Arranua/automated-wheel-installation-system/images/sequence/PLC Sequence 5.jpeg

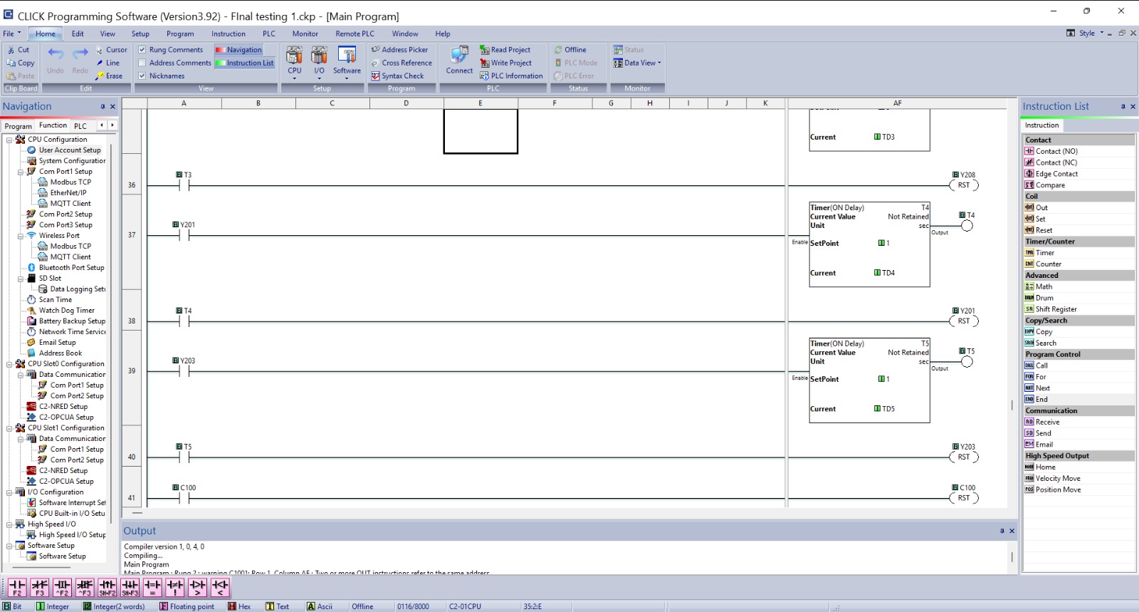
images/sequence/PLC Sequence 5.jpeg
