Arranua/automated-wheel-installation-system/images/sequence/PLC Sequence 1.jpeg

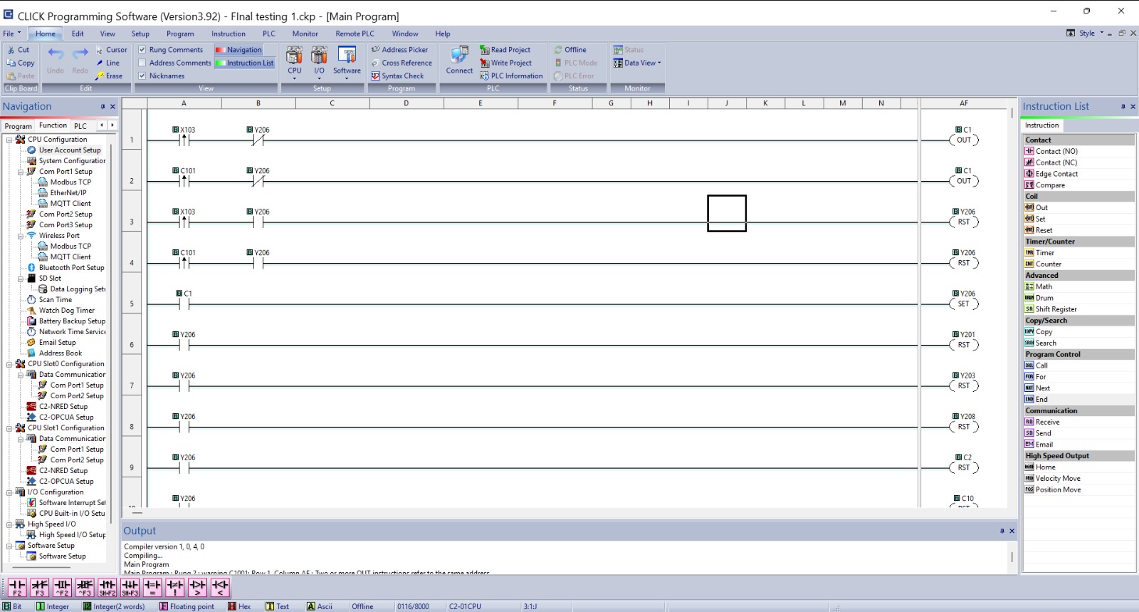
images/sequence/PLC Sequence 1.jpeg
