Arranua/automated-wheel-installation-system/code/plc/README.md

# PLC Code

PLC screenshots, exported program files, ladder logic images, or state-machine notes here.

Expected responsibilities:

- start / stop / reset sequence
- sensor validation
- ESP32 start commands
- done feedback handling
- solenoid/trapdoor output
- cycle complete logic
