Arranua/automated-wheel-installation-system/08_Future_Work.md

# 08 - Future Work

## Planned Improvements

- add final wiring diagrams
- add final NX assembly screenshots
- add full operation video
- add PLC screenshots and ladder/function block screenshots
- improve cable routing and labeling
- add more sensor confirmation points
- improve mechanical wheel alignment features
- create a cleaner HMI or Node-RED dashboard

## Industrial Upgrade Ideas

- closed-loop stepper or servo feedback
- fault codes on HMI/SCADA screen
- dedicated motor controllers instead of prototype wiring
- fused DC distribution
- DIN rail terminals and labeled wiring
- panel-mounted relays and interface modules
- more robust guarding and safety interlocks
