Arranua/automated-wheel-installation-system/images/CAD/gantry plates 2.png

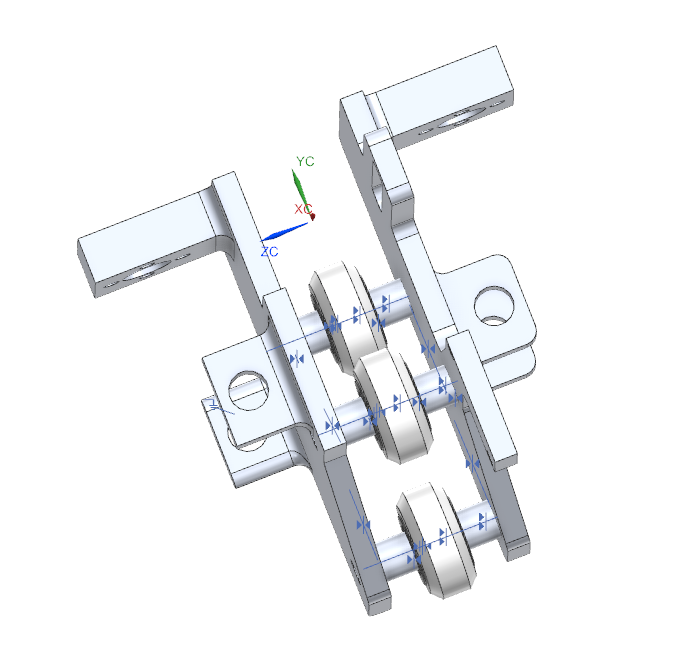
images/CAD/gantry plates 2.png
