Arranua/automated-wheel-installation-system/images/CAD/gantry plates.png

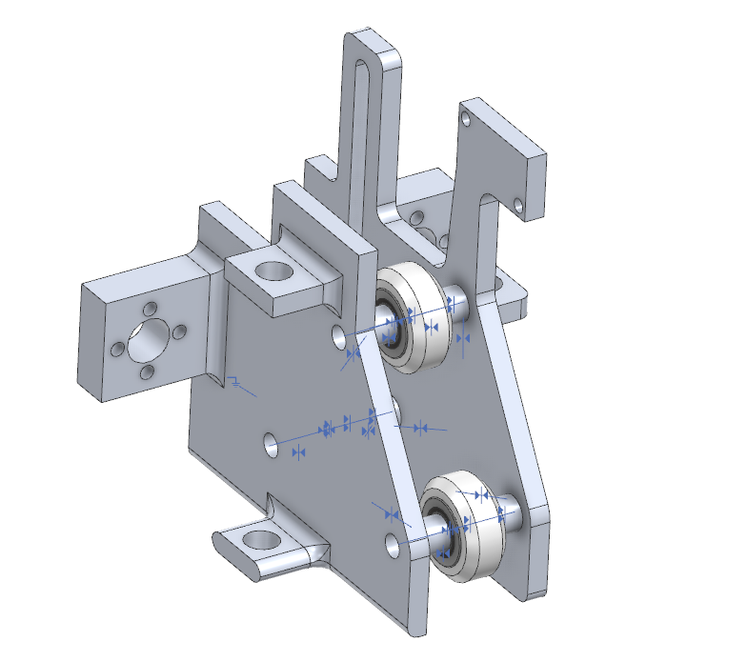
images/CAD/gantry plates.png
