Arranua/automated-wheel-installation-system/images/CAD/gripper.png

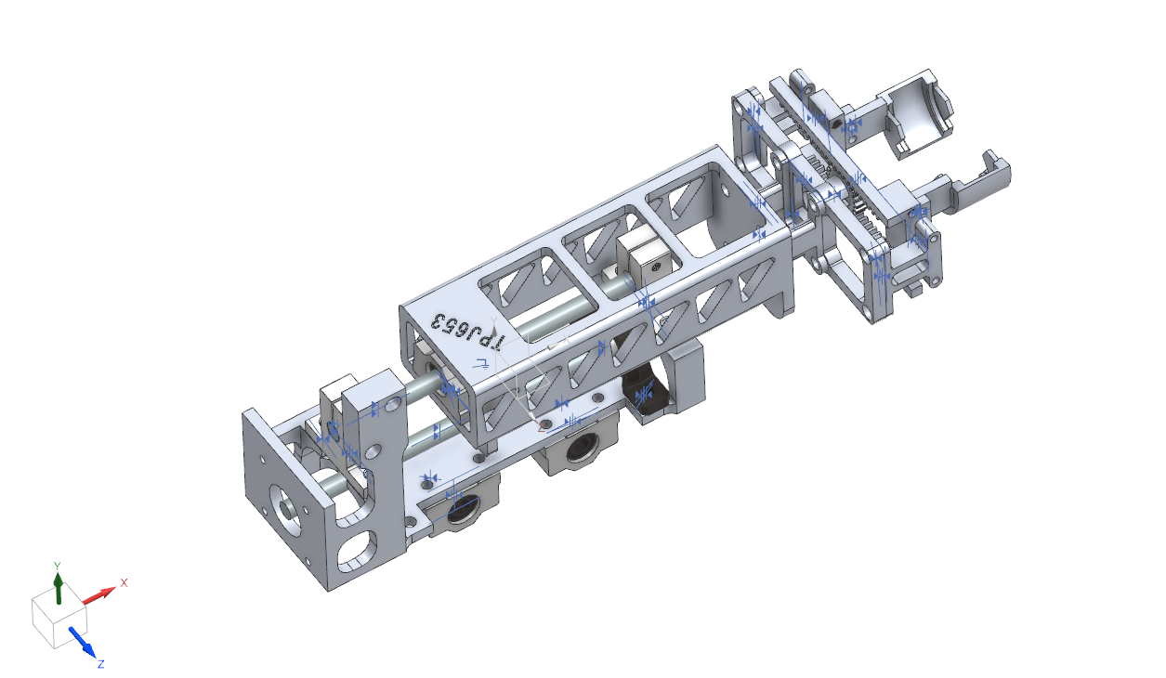
images/CAD/gripper.png
