Arranua/automated-wheel-installation-system/images/CAD/wheel magazine.png

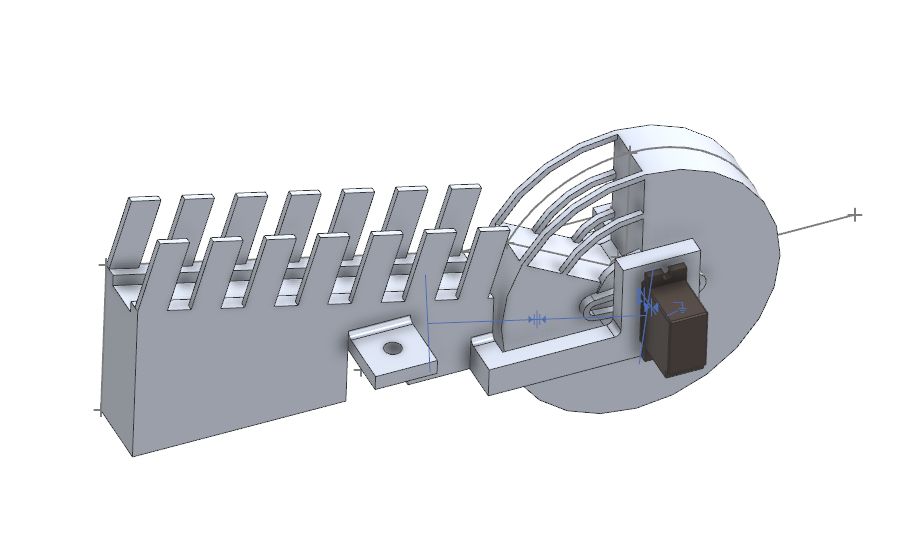
images/CAD/wheel magazine.png
