Arranua/automated-wheel-installation-system/images/scada_iot/dashboard.jpeg

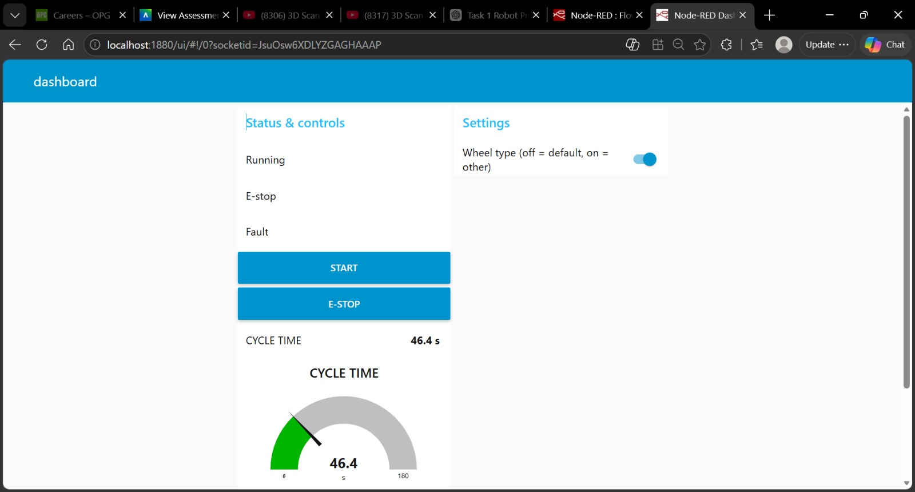
images/scada_iot/dashboard.jpeg
