Arranua/automated-wheel-installation-system/images/sequence/PLC Sequence 2.jpeg

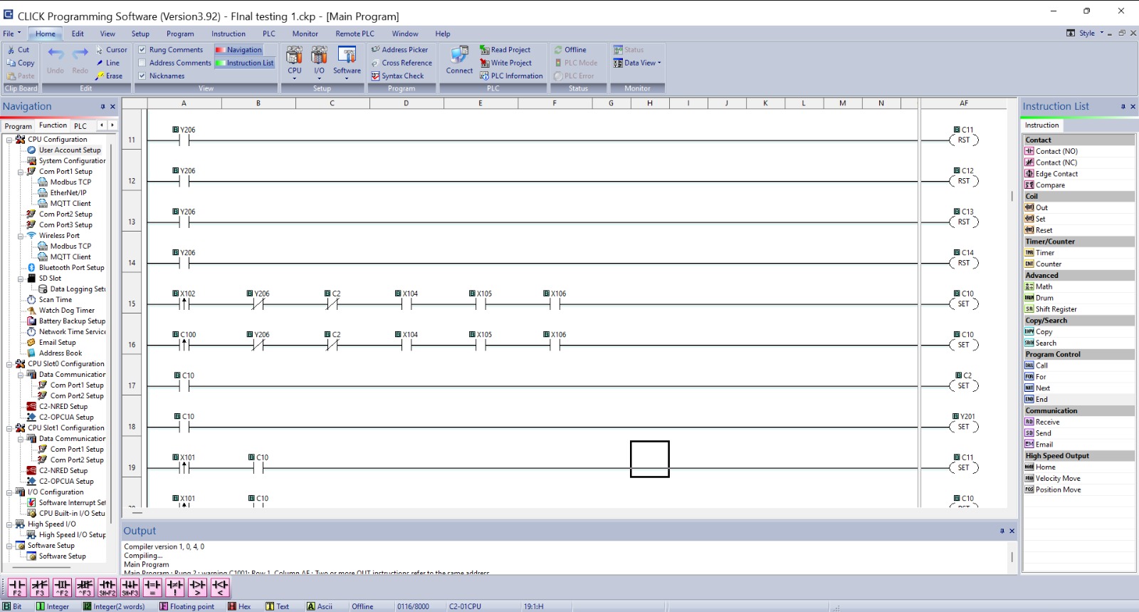
images/sequence/PLC Sequence 2.jpeg
