Arranua/automated-wheel-installation-system/images/sequence/PLC Sequence 3.jpeg

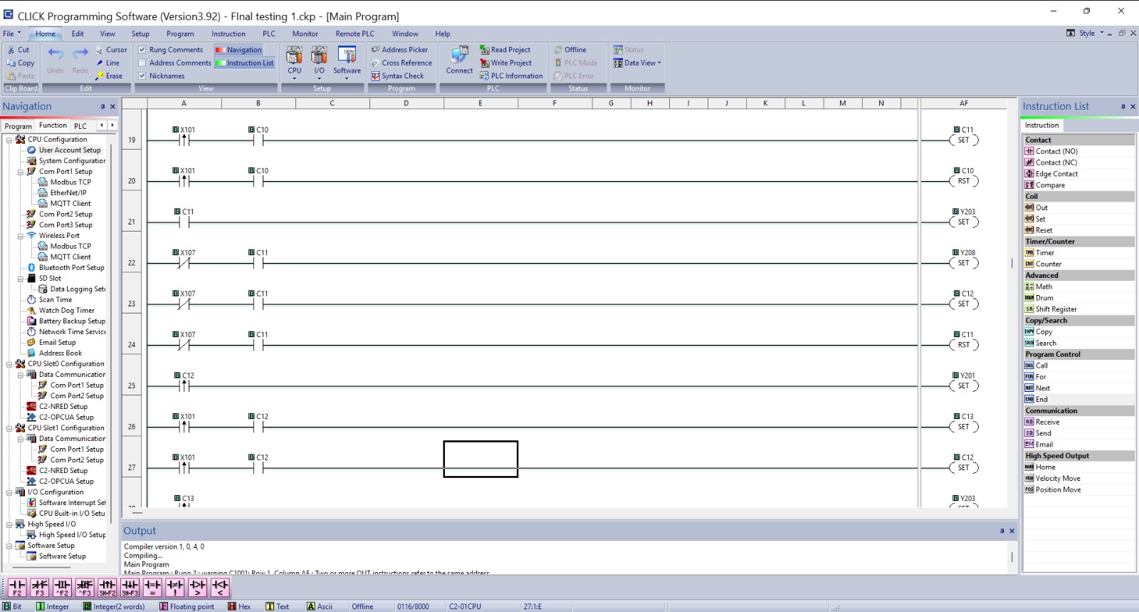
images/sequence/PLC Sequence 3.jpeg
