Arranua/automated-wheel-installation-system/images/sequence/PLC Sequence 6.jpeg

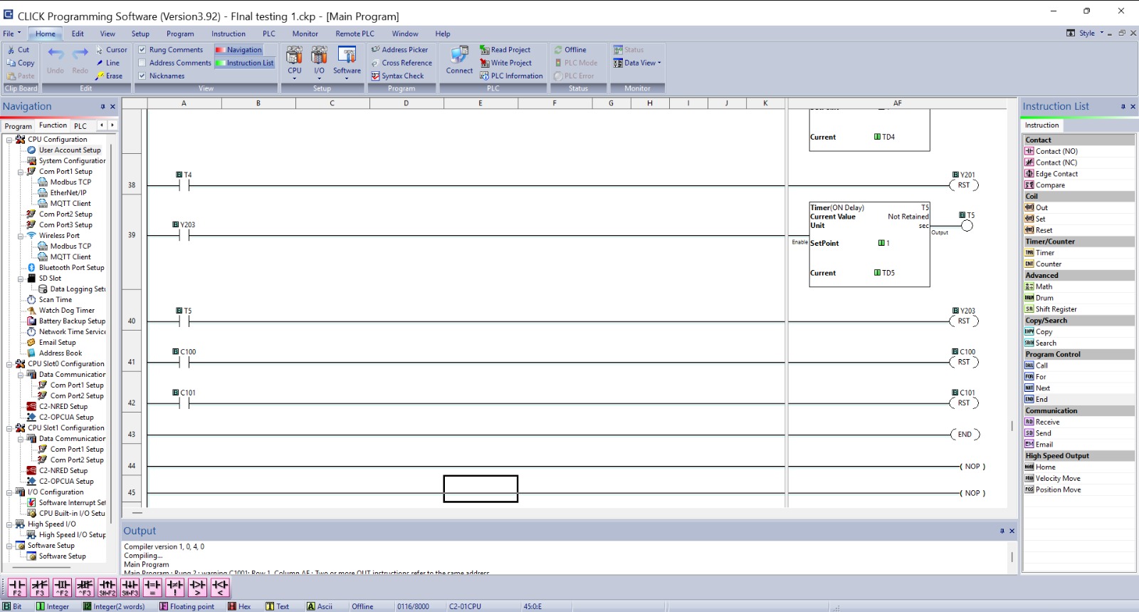
images/sequence/PLC Sequence 6.jpeg
