Arranua/automated-wheel-installation-system/02_BOM_and_Parts.md

# Bill of Materials (BOM)

This section lists the main components used in the automated wheel installation system.

The original Excel BOM can be uploaded in the `docs/` folder and linked from this page.

## Cost Summary

| Section | Subtotal |
|---|---:|
| Controllers & PLC System | $500.00 |
| Power & Electrical Wiring | $188.27 |
| Motion System | $481.28 |
| Sensors & Switches | $112.00 |
| Actuators & Wheel Handling | $21.00 |
| Fasteners & Mechanical Hardware | $64.00 |
| **Grand Total (CAD)** | **$1,366.55** |

---

## Controllers & PLC System

| Part | Qty | Unit Cost | Total Cost | Specification / Model | Image | Link |
|:---|:---:|---:|---:|---|:---:|:---:|
| **ESP32-WROOM microcontroller** | 3 | $13.00 | $39.00 | 30/38 pin | - | [Link](https://www.amazon.ca/dp/B0C9VSYS4N) |
| **ESP32-WROOM breakout board** | 3 | $14.00 | $42.00 | - | - | [Link](https://www.amazon.ca/dp/B0BYS6THLF) |
| **CLICK PLUS PLC with input/output modules** | 1 | $400.00 | $400.00 | - | - | [Link](https://www.automationdirect.com/clickplcs/clickplus) |
| **Relay board** | 1 | $19.00 | $19.00 | 8-position, 24V coil/input | - | [Link](https://www.amazon.ca/Relay-Module-Trigger-Channel-Optocoupler/dp/B08Y76VMWZ) |

---

## Power & Electrical Wiring

| Part | Qty | Unit Cost | Total Cost | Specification / Model | Image | Link |
|:---|:---:|---:|---:|---|:---:|:---:|
| **24VDC power supply** | 1 | $24.00 | $24.00 | 24V, 10A | - | [Link](https://www.amazon.ca/Redrex-Universal-Regulated-Switching-Temperature-Controlled/dp/B0816LK4H2) |
| **Stranded wire** | 1 | $15.00 | $15.00 | 22 AWG, 100 ft | - | [Link](https://www.amazon.ca/BNTECHGO-Silicone-Flexible-Stranded-Impedance/dp/B01K4RPAZ8) |
| **Stranded wire** | 1 | $15.00 | $15.00 | 18 AWG, 100 ft | - | [Link](https://www.amazon.ca/VIABRICO-Electrical-Stranded-Voltage-Extension/dp/B08D6VND2B) |
| **Terminal blocks / power distributors** | 8 | $7.00 | $56.00 | - | - | [Link](https://www.amazon.ca/dp/B0B19ZYY6R) |
| **Step-down buck converter** | 2 | $8.50 | $17.00 | 24V to 5V | - | [Link](https://www.amazon.ca/dp/B0CXXP7RHP) |
| **Ferrules** | 1 | $16.37 | $16.37 | 18 AWG, pack of 100 | - | [Link](https://www.amazon.ca/Insulated-Ferrules-Terminal-Connectors-Terminals/dp/B0DQLRQQZ9) |
| **Ferrules** | 1 | $14.95 | $14.95 | 22 AWG, pack of 100 | - | [Link](https://shop.sayal.com/products/gqta-2338-100) |
| **Spade/fork connectors** | 1 | $11.00 | $11.00 | 18–22 AWG, pack of 100 | - | [Link](https://www.amazon.ca/Baomain-Insulated-Terminal-22-18-Gauge/dp/B01B17DL0G) |
| **Plastic cable duct with cover** | 1 | $14.95 | $14.95 | 4mm | - | [Link](https://secure.sayal.com/STORE4/prodetails.php?SKU=239863) |
| **Inline fuse holder** | 1 | $3.00 | $3.00 | 12 AWG | - | [Link](https://www.amazon.ca/dp/B0FZB9GV1C) |
| **Inline fuse** | 1 | $1.00 | $1.00 | 10A | - | [Link](https://www.amazon.ca/dp/B0FZB9GV1C) |

---

## Motion System

| Part | Qty | Unit Cost | Total Cost | Specification / Model | Image | Link |
|:---|:---:|---:|---:|---|:---:|:---:|
| **Stepper motor driver** | 6 | $17.00 | $102.00 | TB6600 | - | [Link](https://www.amazon.ca/dp/B0D2L5GP1M) |
| **Stepper motor** | 6 | $9.00 | $54.00 | NEMA 17 | - | [Link](https://www.amazon.ca/dp/B0B1Q51G8L) |
| **Servo motor** | 6 | $4.00 | $24.00 | MG90S | - | [Link](https://www.amazon.ca/dp/B0BWJ26PX2) |
| **Lead screw** | 4 | $9.50 | $38.00 | T8, 400 mm | - | [Link](https://www.amazon.ca/dp/B0981YNCNC) |
| **Lead screw** | 3 | $4.00 | $12.00 | T8, 150 mm | - | [Link](https://www.amazon.ca/dp/B0BJVDYRCG) |
| **Timing belt** | 4 | $11.52 | $46.08 | 2GT, 400 mm | - | [Link](https://www.amazon.ca/dp/B0CMSW82FX) |
| **Linear guide rail block** | 6 | $3.00 | $18.00 | SCS8UU | - | [Link](https://www.amazon.ca/dp/B0BJVDYRCG) |
| **Steel shaft guide** | 6 | $3.00 | $18.00 | 8 mm × 400 mm | - | [Link](https://www.amazon.ca/dp/B0BJVDYRCG) |
| **Linear bearing / 3D printer wheel** | 12 | $1.60 | $19.20 | 625ZZ | - | [Link](https://www.amazon.ca/dp/B07Q5WN3GK) |
| **Flexible shaft coupling** | 5 | $12.00 | $60.00 | 5 mm to 8 mm | - | [Link](https://www.amazon.ca/dp/B07PCSP3KZ) |
| **Aluminum extrusion** | 12 | $7.50 | $90.00 | 2020 V-slot, 400 mm | - | [Link](https://www.amazon.ca/dp/B0B7DXYFZ5) |

---

## Sensors & Switches

| Part | Qty | Unit Cost | Total Cost | Specification / Model | Image | Link |
|:---|:---:|---:|---:|---|:---:|:---:|
| **Limit switch** | 6 | $7.00 | $42.00 | - | - | [Link](https://www.amazon.ca/Baomain-Switch-TM-1703-Roller-Terminals/dp/B01HKVDL2U) |
| **Capacitive Sensor** | 1 | $15.00 | $15.00 | LJC18A3-H-Z/BY | - | [Link](https://www.amazon.ca/Heschen-capacitive-proximity-LJC18A3-H-Z-detector) |
| **Photoelectric Sensor, Diffuse** | 2 | $17.00 | $34.00 | DC6-36V | - | [Link](https://www.amazon.ca/dp/B07TJHDXP6) |
| **Photoelectric Sensor, Retro-reflective** | 1 | $21.00 | $21.00 | E3F-R2NK | - | [Link](https://www.amazon.ca/dp/B09LCNBX6S) |

---

## Actuators & Wheel Handling

| Part | Qty | Unit Cost | Total Cost | Specification / Model | Image | Link |
|:---|:---:|---:|---:|---|:---:|:---:|
| **Solenoid** | 1 | $21.00 | $21.00 | 24V, 0.4A, push-pull type | - | [Link](https://www.amazon.ca/dp/B0DQCXNB5S) |

---

## Fasteners & Mechanical Hardware

| Part | Qty | Unit Cost | Total Cost | Specification / Model | Image | Link |
|:---|:---:|---:|---:|---|:---:|:---:|
| **Machine screw** | 1 | $10.00 | $10.00 | M3 × 16 mm, pack of 100 | - | [Link](https://www.amazon.ca/dp/B0D9PX9R2H) |
| **Nut** | 1 | $9.00 | $9.00 | M3, pack of 100 | - | [Link](https://www.amazon.ca/LEONTOOL-Inserted-Assortment-Stainless-Clinching/dp/B0BMX3F4P3) |
| **Machine screw** | 1 | $20.00 | $20.00 | M5 × 16 mm, pack of 100 | - | [Link](https://www.amazon.ca/dp/B0B9HYHCT9) |
| **Nut** | 1 | $15.00 | $15.00 | M5, pack of 100 | - | [Link](https://www.amazon.ca/dp/B0F8W1L1T8) |
| **Machine screw** | 1 | $10.00 | $10.00 | M4 × 12 mm, pack of 30 | - | [Link](https://www.amazon.ca/dp/B0D9PVKYP9) |

---

## Notes

- Costs are approximate and may change depending on supplier availability.
- Images can be added later by placing component pictures in `images/bom/` and replacing the `-` entries in the Image column with HTML image tags.
- Example image syntax: `<img src="images/bom/stepper_motor.png" width="140" alt="Stepper motor">`
- This Markdown BOM is intended for quick GitHub viewing; the Excel file should be kept as the editable source BOM.
