Arranua/automated-wheel-installation-system/docs/Bill Of Materials.xlsx

Bill of Materials (BOM)
Item | Component | Specification / Model | Qty | Supplier / Link | Unit Cost | Total Cost
1 | ESP32-WROOM microcontroller | 30/38 pin | 3 | https://www.amazon.ca/dp/B0C9VSYS4N | $13.00 | $39.00
2 | ESP32-WROOM breakout board |  | 3 | https://www.amazon.ca/dp/B0BYS6THLF | $14.00 | $42.00
3 | 24VDC power supply | 24V, 10A | 1 | https://www.amazon.ca/Redrex-Universal-Regulated-Switching-Temperature-Controlled/dp/B0816LK4H2 | $24.00 | $24.00
4 | Stranded wire | 22 AWG, 100 ft | 1 | https://www.amazon.ca/BNTECHGO-Silicone-Flexible-Stranded-Impedance/dp/B01K4RPAZ8 | $15.00 | $15.00
5 | Stranded wire | 18 AWG, 100 ft | 1 | https://www.amazon.ca/VIABRICO-Electrical-Stranded-Voltage-Extension/dp/B08D6VND2B | $15.00 | $15.00
6 | Terminal blocks / power distributors |  | 8 | https://www.amazon.ca/dp/B0B19ZYY6R | $7.00 | $56.00
7 | CLICK PLUS PLC with input/output modules |  | 1 | https://www.automationdirect.com/clickplcs/clickplus | $400.00 | $400.00
8 | Step-down buck converter | 24V to 5V | 2 | https://www.amazon.ca/dp/B0CXXP7RHP | $8.50 | $17.00
9 | Ferrules | 18 AWG, pack of 100 | 1 | https://www.amazon.ca/Insulated-Ferrules-Terminal-Connectors-Terminals/dp/B0DQLRQQZ9 | $16.37 | $16.37
10 | Ferrules | 22 AWG, pack of 100 | 1 | https://shop.sayal.com/products/gqta-2338-100 | $14.95 | $14.95
11 | Spade/fork connectors | 18–22 AWG, pack of 100 | 1 | https://www.amazon.ca/Baomain-Insulated-Terminal-22-18-Gauge/dp/B01B17DL0G | $11.00 | $11.00
12 | Plastic cable duct with cover | 4mm | 1 | https://secure.sayal.com/STORE4/prodetails.php?SKU=239863 | $14.95 | $14.95
13 | Relay board | 8-position, 24V coil/input | 1 | https://www.amazon.ca/Relay-Module-Trigger-Channel-Optocoupler/dp/B08Y76VMWZ | $19.00 | $19.00
14 | Stepper motor driver | TB6600 | 6 | https://www.amazon.ca/dp/B0D2L5GP1M | $17.00 | $102.00
15 | Stepper motor | NEMA 17 | 6 | https://www.amazon.ca/dp/B0B1Q51G8L | $9.00 | $54.00
16 | Servo motor | MG90S | 6 | https://www.amazon.ca/dp/B0BWJ26PX2 | $4.00 | $24.00
17 | Limit switch |  | 6 | https://www.amazon.ca/Baomain-Switch-TM-1703-Roller-Terminals/dp/B01HKVDL2U | $7.00 | $42.00
18 | Lead screw | T8, 400 mm | 4 | https://www.amazon.ca/dp/B0981YNCNC | $9.50 | $38.00
19 | Lead screw | T8, 150 mm | 3 | https://www.amazon.ca/dp/B0BJVDYRCG | $4.00 | $12.00
20 | Timing belt | 2GT, 400 mm | 4 | https://www.amazon.ca/dp/B0CMSW82FX | $11.52 | $46.08
21 | Inline fuse holder | 12 AWG | 1 | https://www.amazon.ca/dp/B0FZB9GV1C | $3.00 | $3.00
22 | Inline fuse | 10A | 1 | https://www.amazon.ca/dp/B0FZB9GV1C | $1.00 | $1.00
23 | Solenoid | 24V, 0.4A, push-pull type | 1 | https://www.amazon.ca/dp/B0DQCXNB5S | $21.00 | $21.00
24 | Linear guide rail block | SCS8UU | 6 | https://www.amazon.ca/dp/B0BJVDYRCG | $3.00 | $18.00
25 | Steel shaft guide | 8 mm × 400 mm | 6 | https://www.amazon.ca/dp/B0BJVDYRCG | $3.00 | $18.00
26 | Linear bearing / 3D printer wheel | 625ZZ | 12 | https://www.amazon.ca/dp/B07Q5WN3GK | $1.60 | $19.20
27 | Flexible shaft coupling | 5 mm to 8 mm | 5 | https://www.amazon.ca/dp/B07PCSP3KZ | $12.00 | $60.00
28 | Aluminum extrusion | 2020 V-slot, 400 mm | 12 | https://www.amazon.ca/dp/B0B7DXYFZ5 | $7.50 | $90.00
29 | Machine screw | M3 × 16 mm, pack of 100 | 1 | https://www.amazon.ca/dp/B0D9PX9R2H | $10.00 | $10.00
30 | Nut | M3, pack of 100 | 1 | https://www.amazon.ca/LEONTOOL-Inserted-Assortment-Stainless-Clinching/dp/B0BMX3F4P3 | $9.00 | $9.00
31 | Machine screw | M5 × 16 mm, pack of 100 | 1 | https://www.amazon.ca/dp/B0B9HYHCT9 | $20.00 | $20.00
32 | Nut | M5, pack of 100 | 1 | https://www.amazon.ca/dp/B0F8W1L1T8 | $15.00 | $15.00
33 | Machine screw | M4 × 12 mm, pack of 30 | 1 | https://www.amazon.ca/dp/B0D9PVKYP9 | $10.00 | $10.00
34 | Capacitive Sensor | LJC18A3-H-Z/BY | 1 | https://www.amazon.ca/Heschen-capacitive-proximity-LJC18A3-H-Z-detector | $15.00 | $15.00
35 | Photoelectric Sensor, Diffuse | DC6-36V | 2 | https://www.amazon.ca/dp/B07TJHDXP6 | $17.00 | $34.00
36 | Photoelectric Sensor, Retro-reflective | E3F-R2NK | 1 | https://www.amazon.ca/dp/B09LCNBX6S | $21.00 | $21.00
37 |  |  |  |  |  | $0.00
38 |  |  |  |  |  | $0.00
 |  |  |  |  | Grand Total | $1296.55
