Arranua/automated-wheel-installation-system/images/CAD/project_assembly 2.png

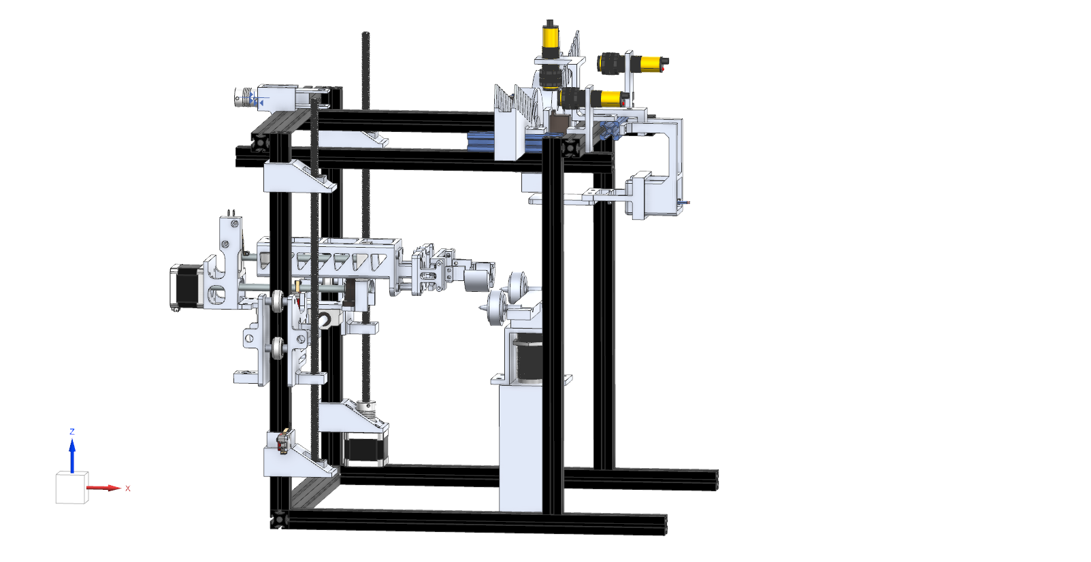
images/CAD/project_assembly 2.png
