Arranua/automated-wheel-installation-system/images/CAD/project_assembly 3.png

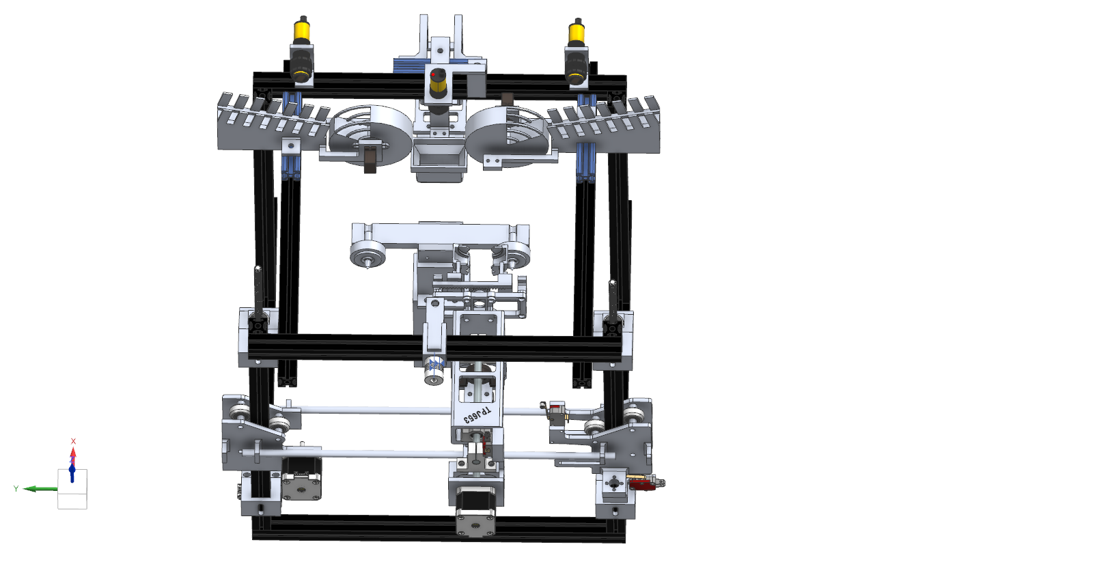
images/CAD/project_assembly 3.png
