Arranua/automated-wheel-installation-system/images/CAD/project_assembly.png

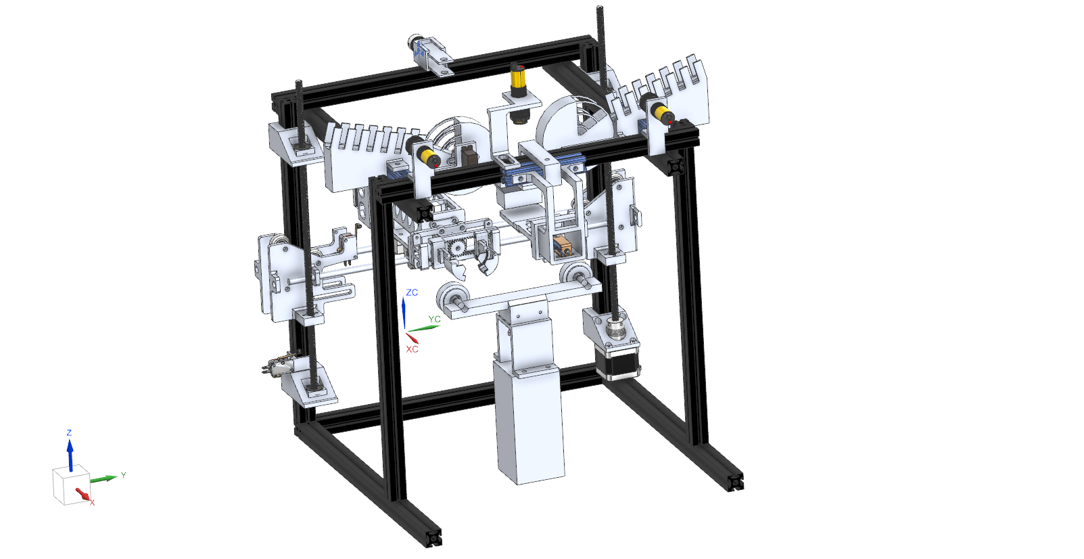
images/CAD/project_assembly.png
