Arranua/automated-wheel-installation-system/images/wiring/Esp32&Servo Control.png

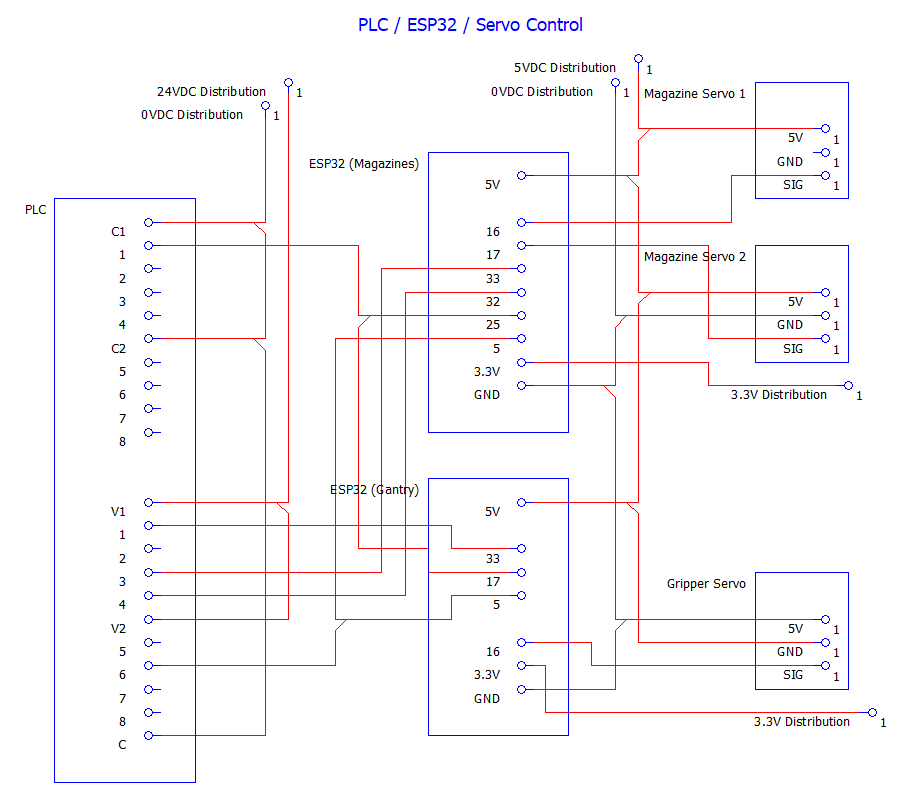
images/wiring/Esp32&Servo Control.png
