Arranua/automated-wheel-installation-system/images/wiring/Power Distribution.png

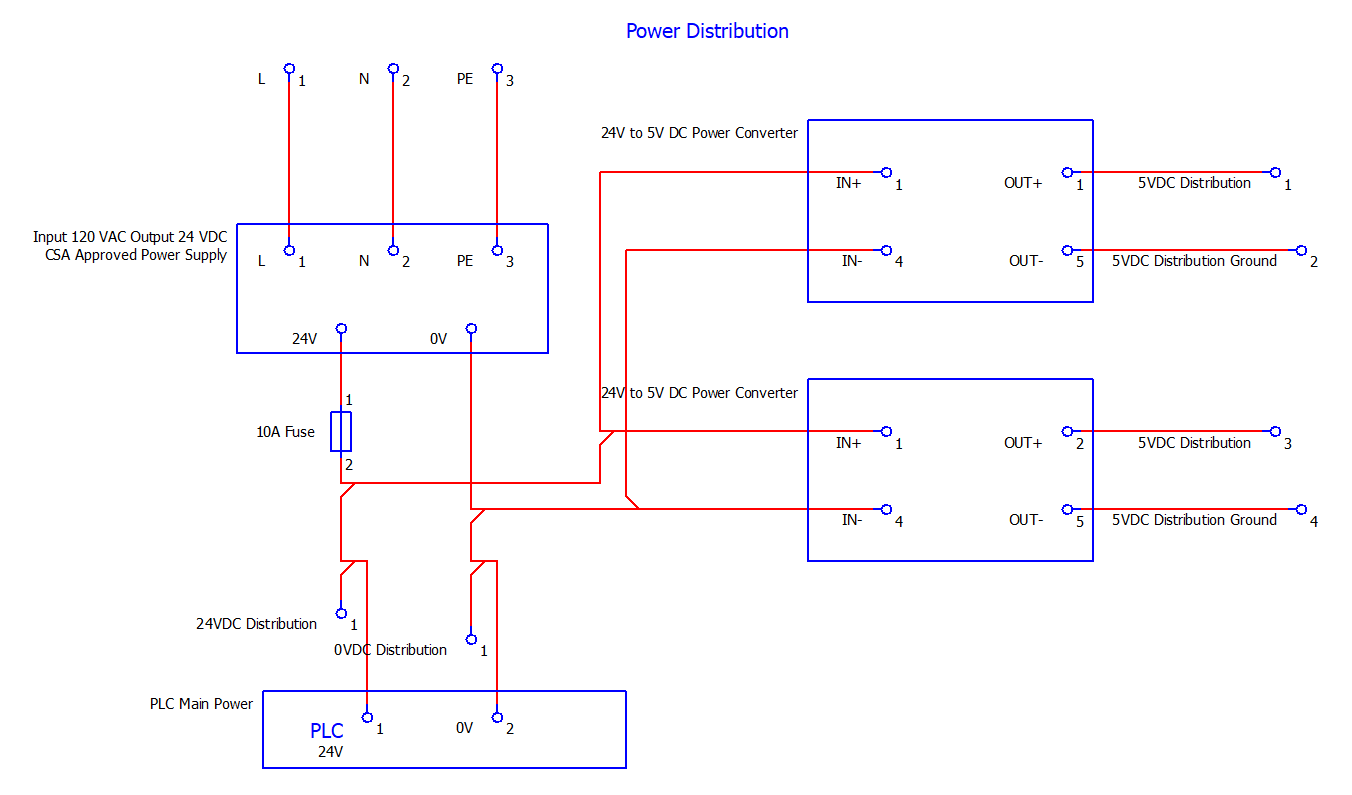
images/wiring/Power Distribution.png
