Arranua/automated-wheel-installation-system/images/wiring/Sensors & Solenoid Control.png

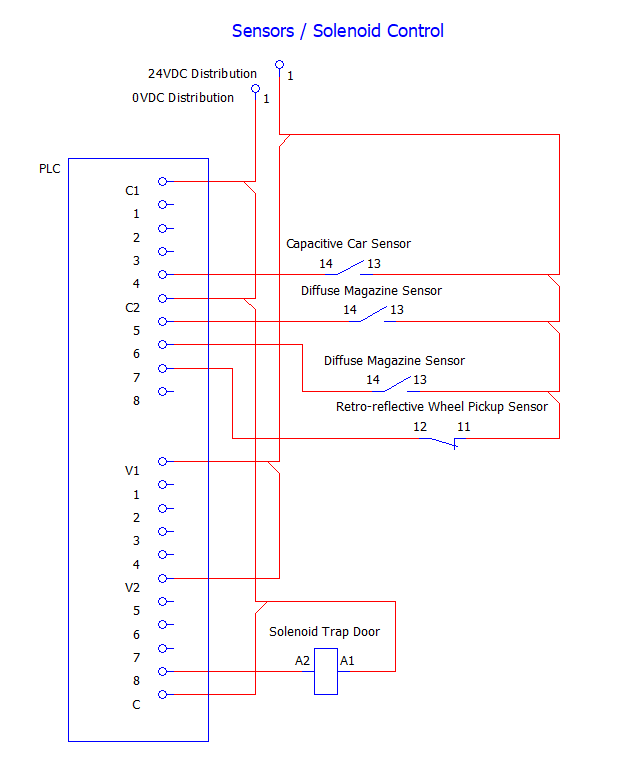
images/wiring/Sensors & Solenoid Control.png
