Arranua/automated-wheel-installation-system/images/wiring/Stepper Motor Control.png

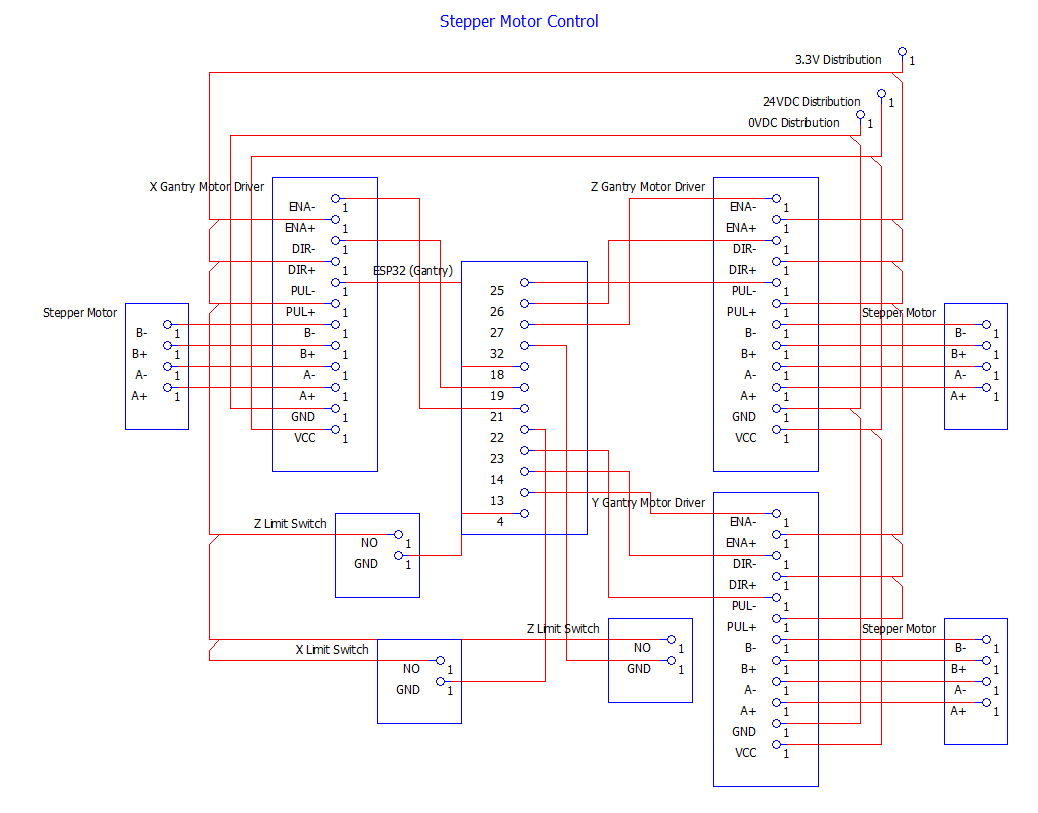
images/wiring/Stepper Motor Control.png
