Arranua/automated-wheel-installation-system/(commit log)

2026-07-27 Add ESP32 magazine controller code to README
    Added ESP32 magazine controller code and documentation.
2026-07-27 Clean up README and remove unused code
    Removed old comments and servo-related code from README.
2026-07-27 Add ESP32 magazine controller functionality
2026-07-27 Update README to remove file addition instructions
    Removed instructions for adding the gantry controller file.
2026-07-27 Add ESP32 gantry control code
    Initial implementation of ESP32 gantry control with servo and axis management.
2026-08-03 Revise electrical wiring documentation
    Updated the wiring documentation to reflect the current project status, including detailed PLC inputs and outputs.
2026-08-03 Delete solenoid switching note from documentation
    Removed solenoid switching note and related diagram.
2026-08-03 Rename Screenshot_34.png to Power Distribution.png
2026-08-03 Rename Screenshot_35.png to Esp32&Servo Control.png
2026-08-03 Rename Screenshot_36.png to Stepper Motor Control.png
2026-08-03 Rename Screenshot_37.png to Sensors & Solenoid Control.png
2026-08-17 Remove 'Current Build Status' from project overview
    Removed the 'Current Build Status' section from the overview.
